Jafaral/neo/giraffe/mazda/mazda_giraffe.brd

## EAGLE design giraffe/mazda/mazda_giraffe.brd (2019-04-22)

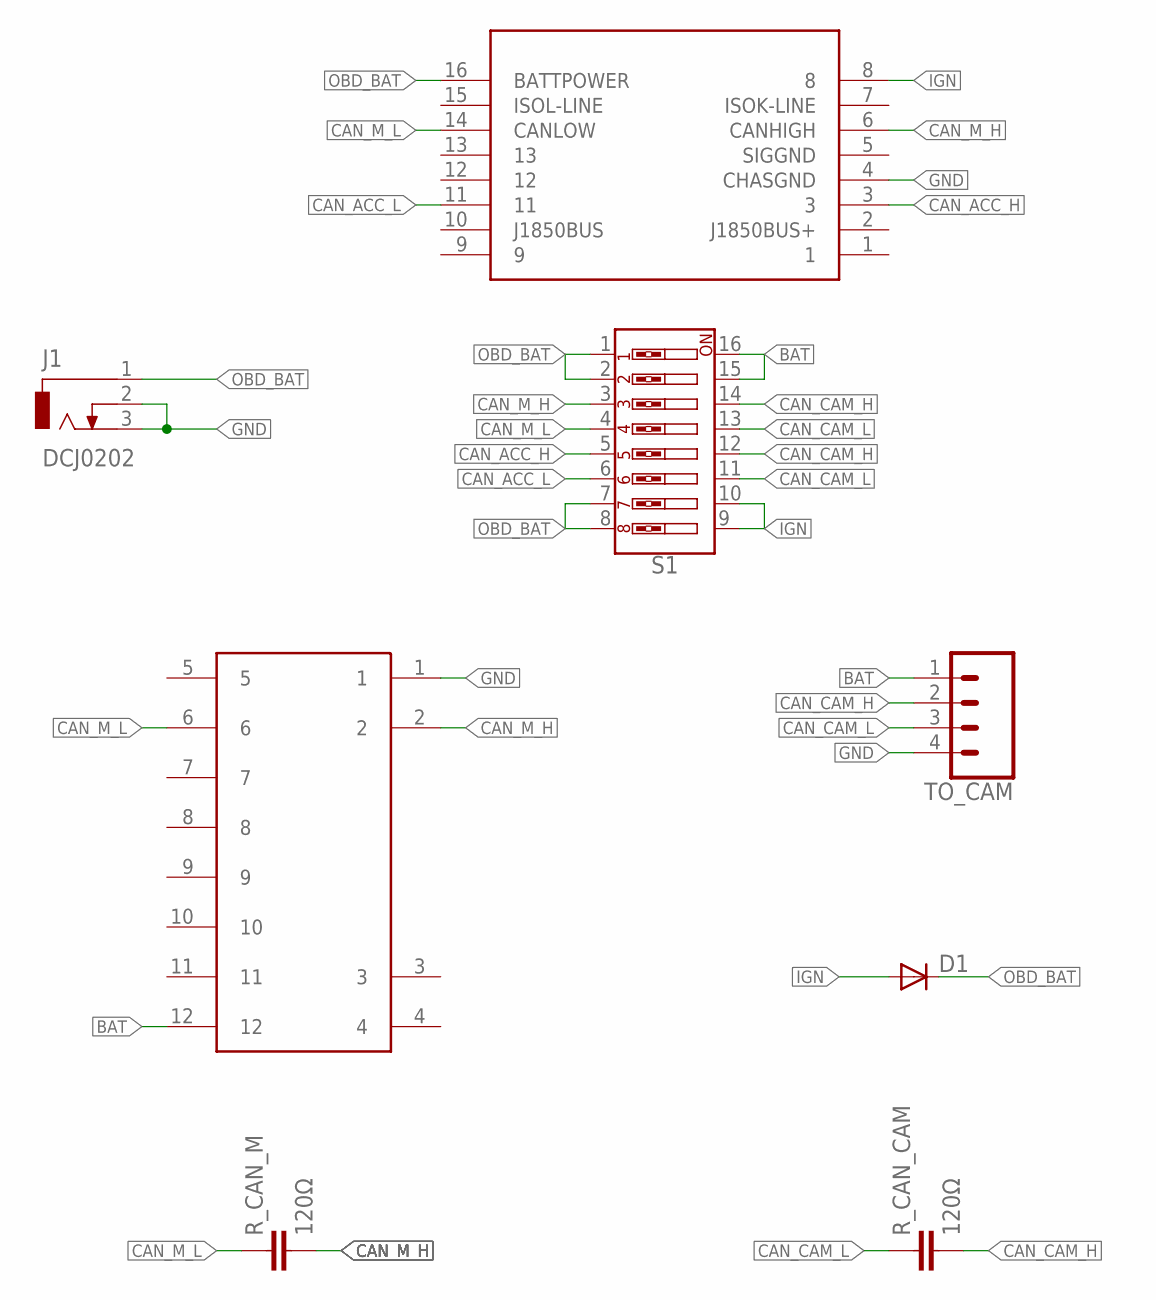
[picture p1: schematic mazda_giraffe.sch]

Parts:
D1: DIODE-DO-214AC; DO-214AC
J1: DCJ0202
OBD_II: OBDII
R_CAN_CAM: 120Ω; C1206
R_CAN_M: 120Ω; C1206
S1: DIP-08-PTH; DIPSWITCH-08
TO_CAM: CONN_04LONGPADS; 1X04_LONGPADS
TO_CAR: 34826-8124

Connections:
BAT: S1.15, S1.16, TO_CAM.1, TO_CAR.12
CAN_ACC_H: OBD_II.3, S1.5
CAN_ACC_L: OBD_II.11, S1.6
CAN_CAM_H: R_CAN_CAM.2, S1.12, S1.14, TO_CAM.2
CAN_CAM_L: R_CAN_CAM.1, S1.11, S1.13, TO_CAM.3
CAN_M_H: OBD_II.6 (CANHIGH), R_CAN_M.2, S1.3, TO_CAR.2
CAN_M_L: OBD_II.14 (CANLOW), R_CAN_M.1, S1.4, TO_CAR.6
GND: J1.2, J1.3, OBD_II.4 (CHASGND), TO_CAM.4, TO_CAR.1
IGN: D1.A, OBD_II.8, S1.9, S1.10
OBD_BAT: D1.C, J1.1, OBD_II.16 (BATTPOWER), S1.1, S1.2, S1.7, S1.8

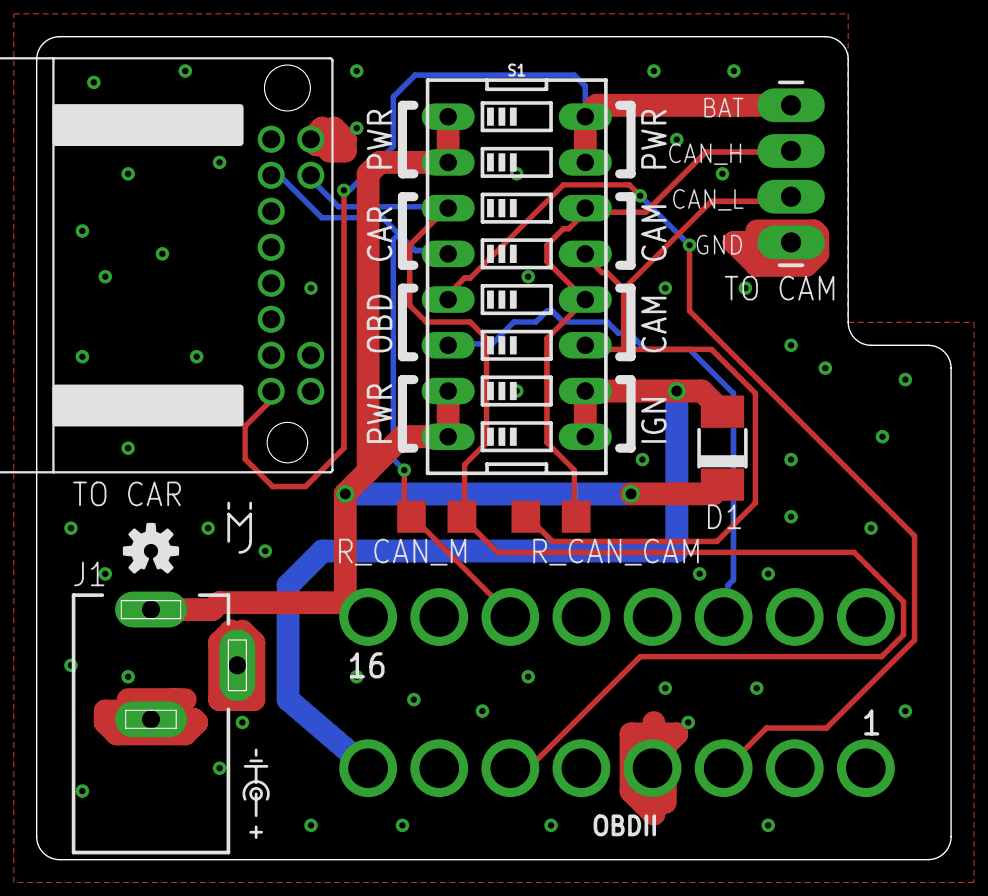
[picture p2: board mazda_giraffe.brd from above]

Board: 2 copper layers, 50.8 x 45.7 mm, 10 parts (1 on the bottom side), 10 nets.

Other parts of the board:
U$1, U$2: OSHW-LOGO-S
