Jafaral/neo/(commit log)

2019-04-22 update the list
    [BOM.csv]
2019-04-22 add the giraffe board and update README
    [mazda_giraffe.brd, mazda_giraffe.sch]
2019-09-23 Update with current giraffe info
2019-09-25 Source from digikey
    [BOM.csv]
